MvdLande/Toy-Audio/V1/REV A/Toy-Audio V1.0 REV A layout.docx

Front Copper

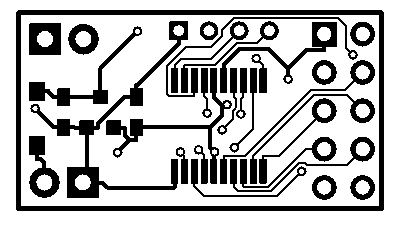
[picture p1: figure]

Front Silkscreen

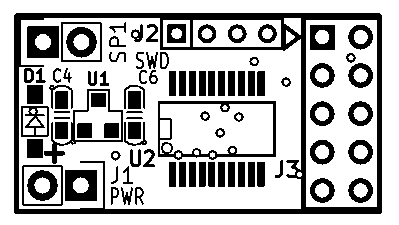
[picture p2: figure]

Back Copper

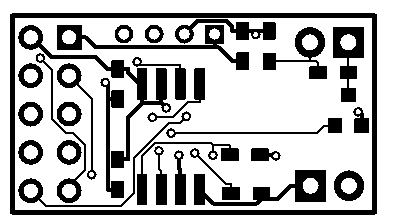
[picture p3: figure]

Back Silkscreen

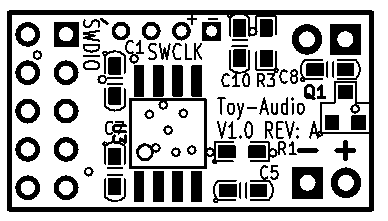
[picture p4: figure]

Toy-Audio V1.0 REV:A
