MvdLande/Toy-Audio/V1/REV A.1/doc/Toy-Audio software structure.docx

.00

I2C debug interface

Simple File System

Power Management

Serial port

WAV Player task

PWM Audio generator task

User Interface

State Machine

SPI FLASH Interface

Xmodem interface

Console Menu
