MvdLande/Toy-Audio/V1/REV A.1/doc/Toy-Audio V1.0 REV A layout.pdf

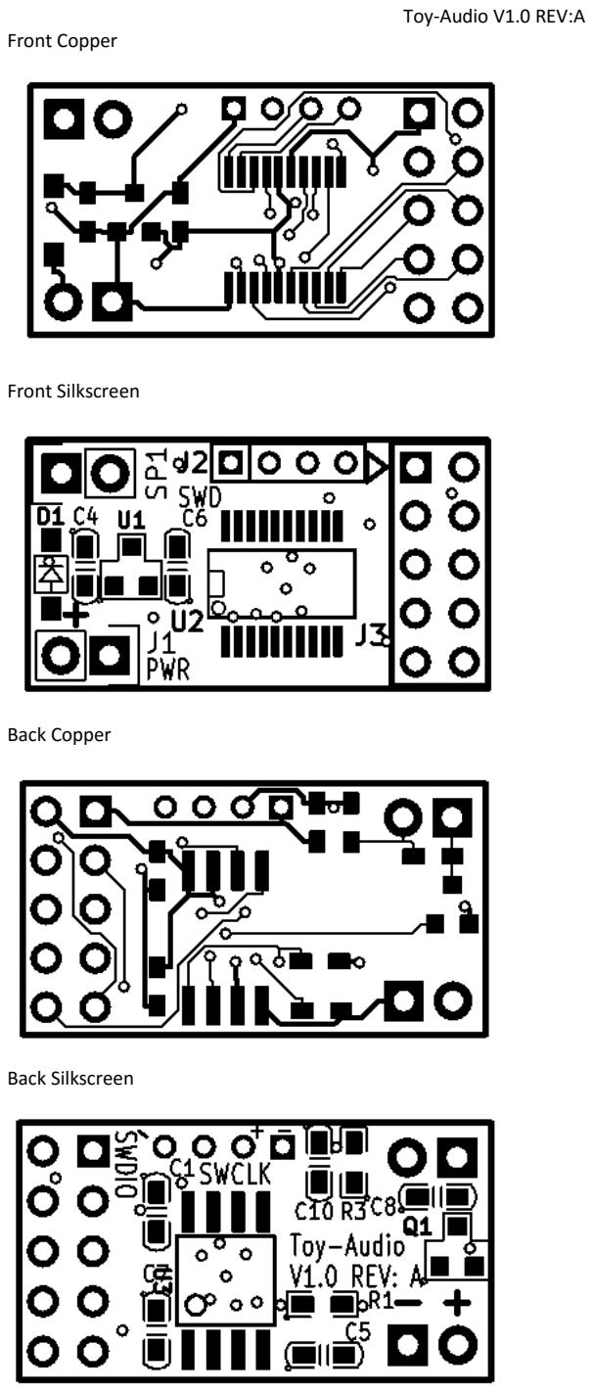
[picture p5: page 1]

Toy-Audio V1.0 REV:A
Front Copper

Front Silkscreen

Back Copper

Back Silkscreen
