MvdLande/Toy-Audio/V2/Hardware/REV A/doc/Hand Soldering guide HW V2 REV A.docx

Copper Front

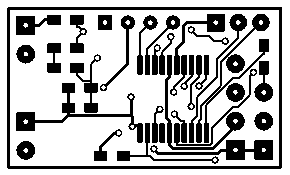
[picture p6: figure]

Components Front

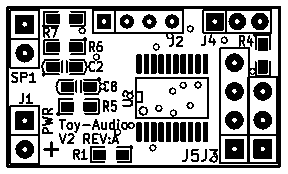
[picture p7: figure]

Copper Back

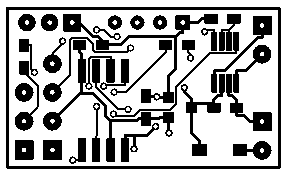
[picture p8: figure]

Components Back

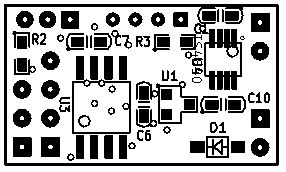
[picture p9: figure]

Toy-Audio V2 REV:A Hand soldering guide
