MvdLande/Toy-Audio/V3/Hardware/REV A/doc/Toy-Audio V3 REV A schematic.pdf

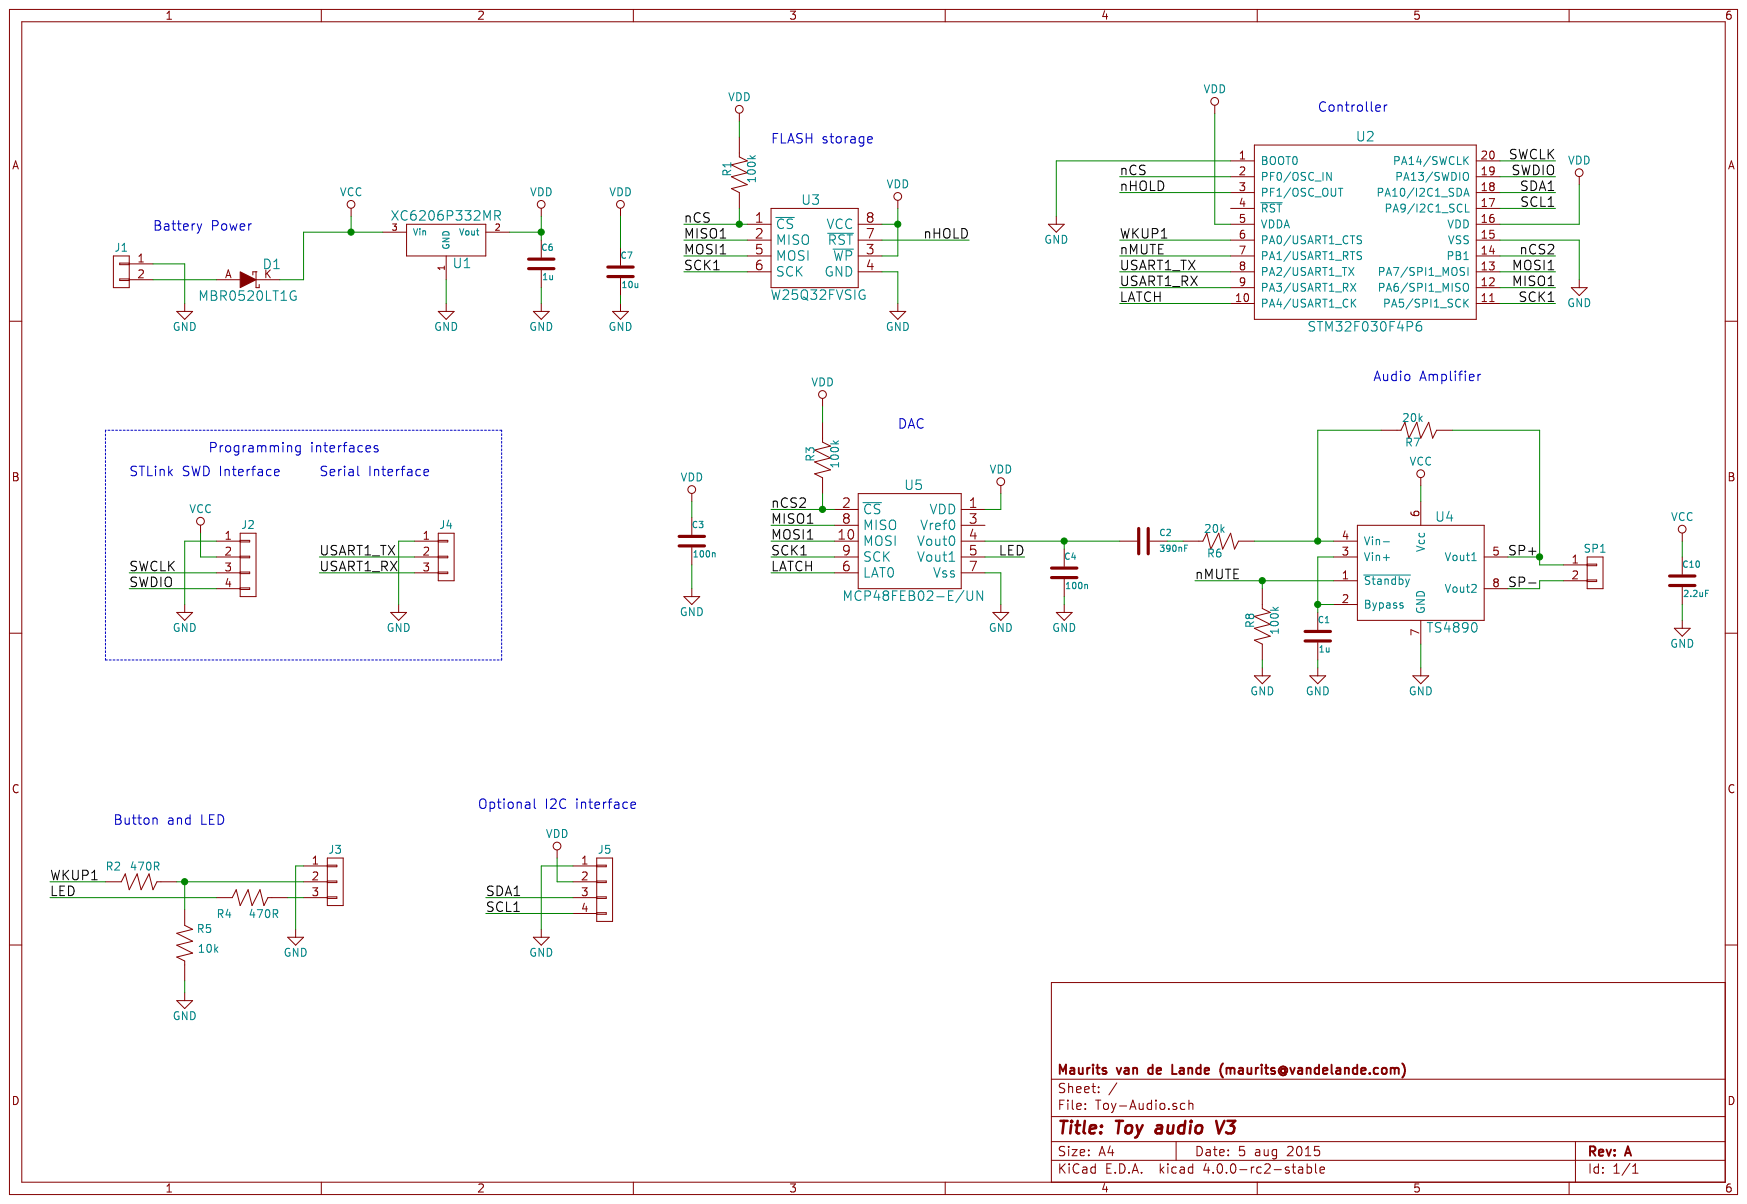
[picture p10: page 1]
