MvdLande/Toy-Audio/V1/REV A.1/doc/Toy-Audio V1.0 REV A.1 schematic.pdf

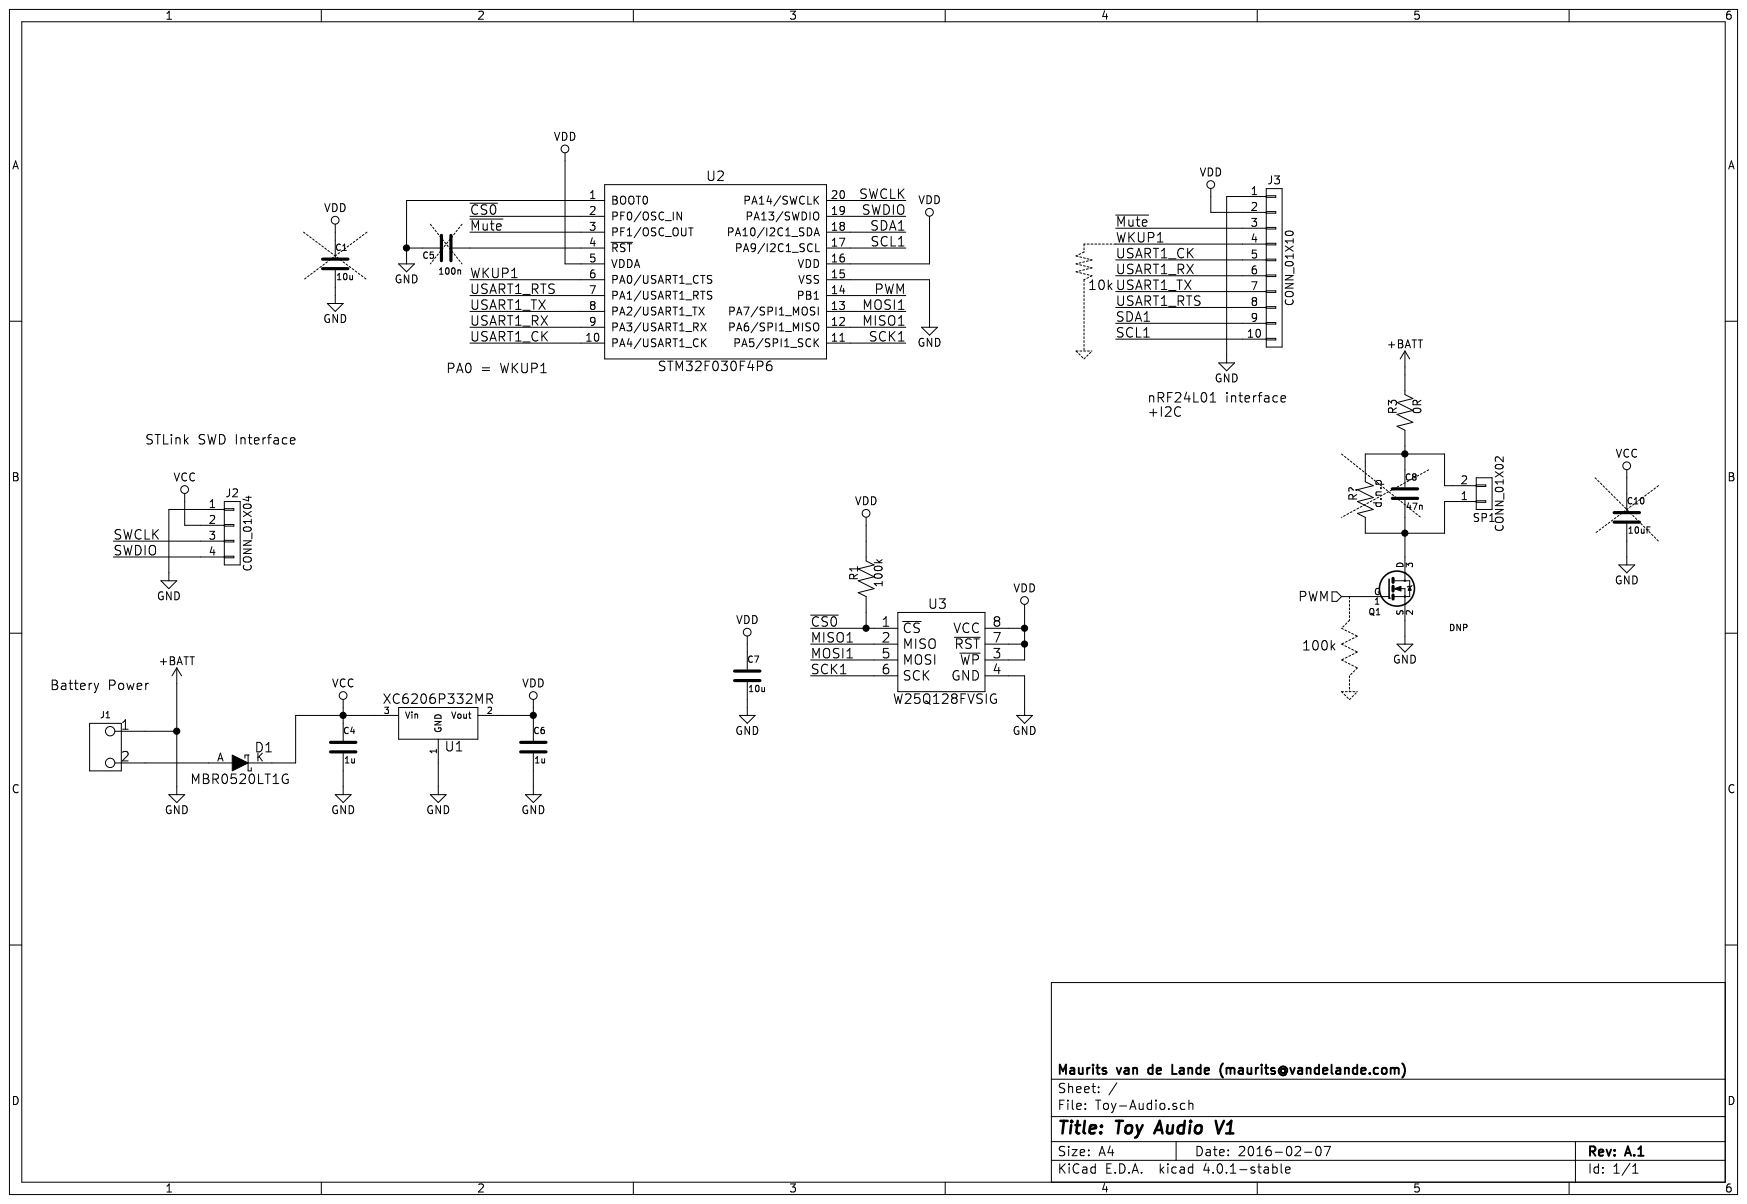
[picture p11: page 1]
