MvdLande/Toy-Audio/V1/REV A/doc/Toy-Audio V1.0 REV A schematic.pdf

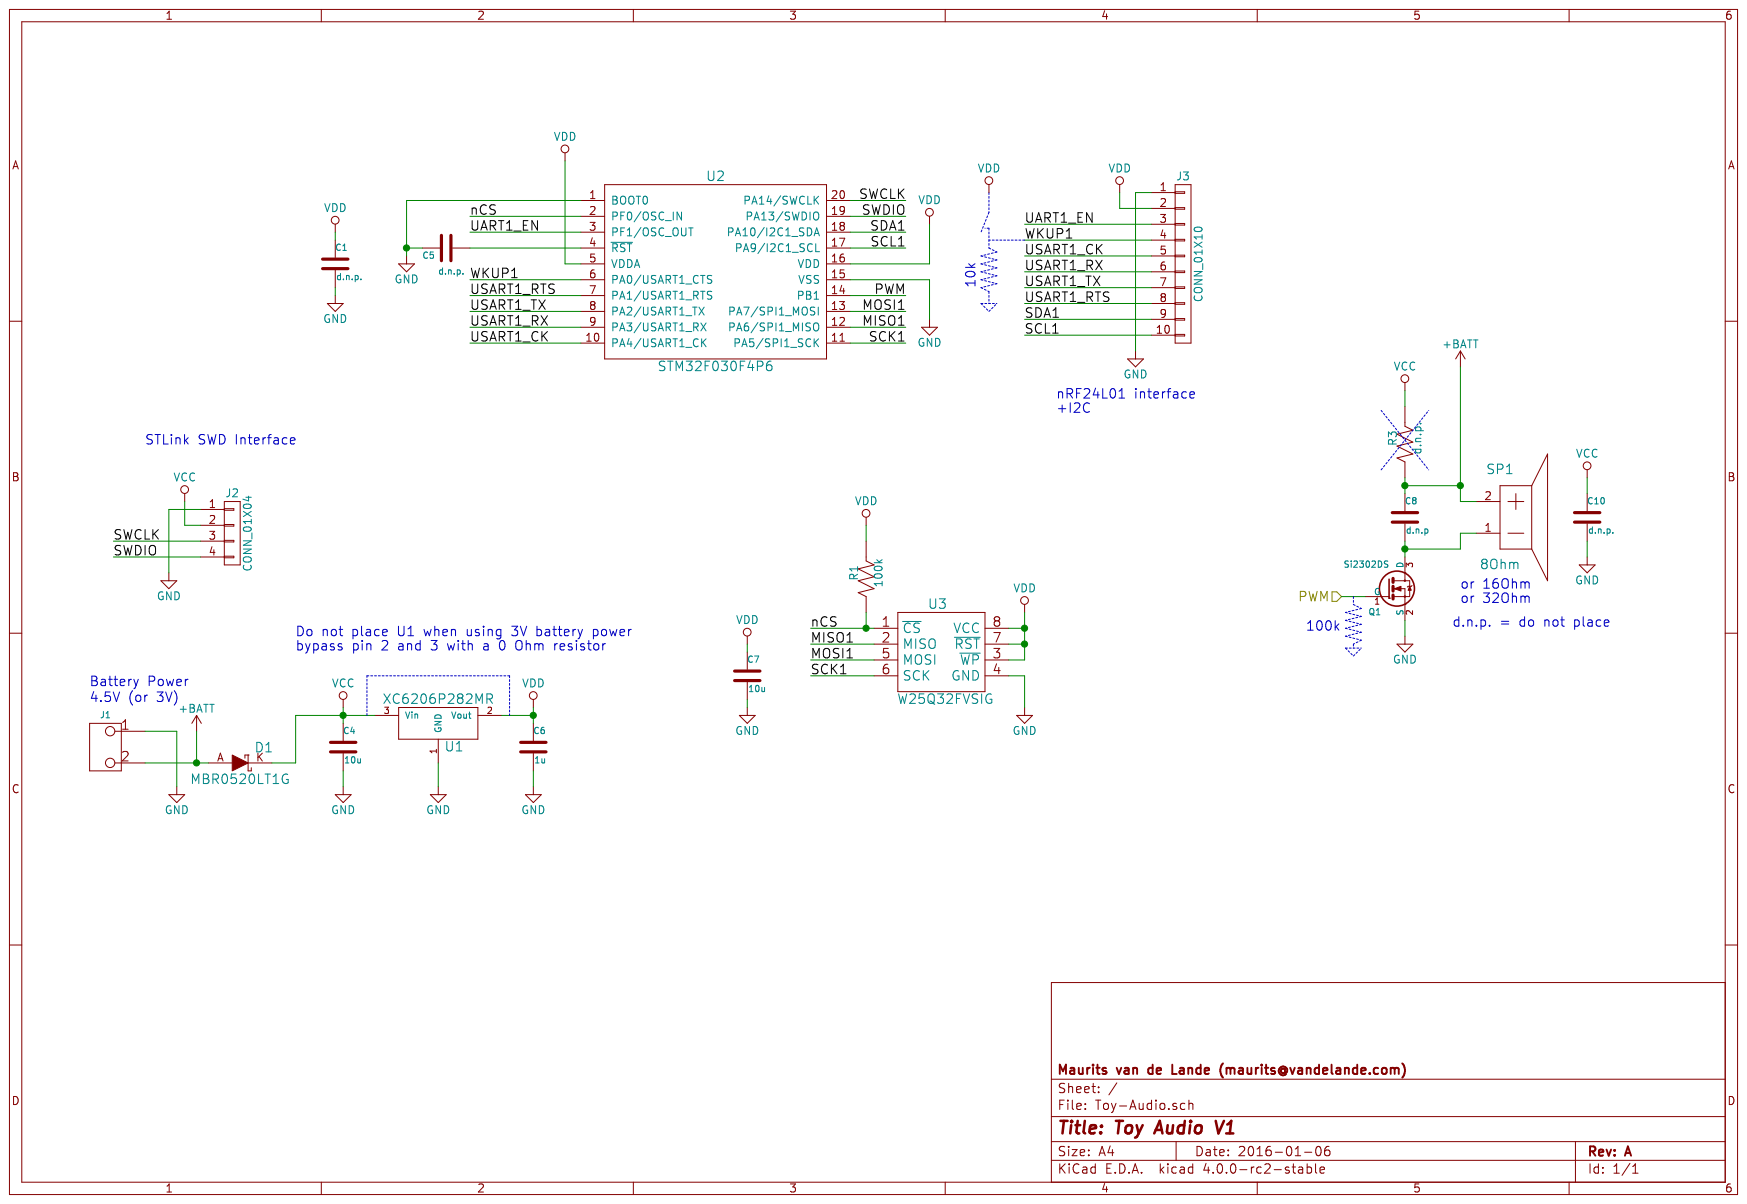
[picture p12: page 1]
