MvdLande/Toy-Audio/V1/REV B/doc/Toy-Audio V1 REV B schematic.pdf

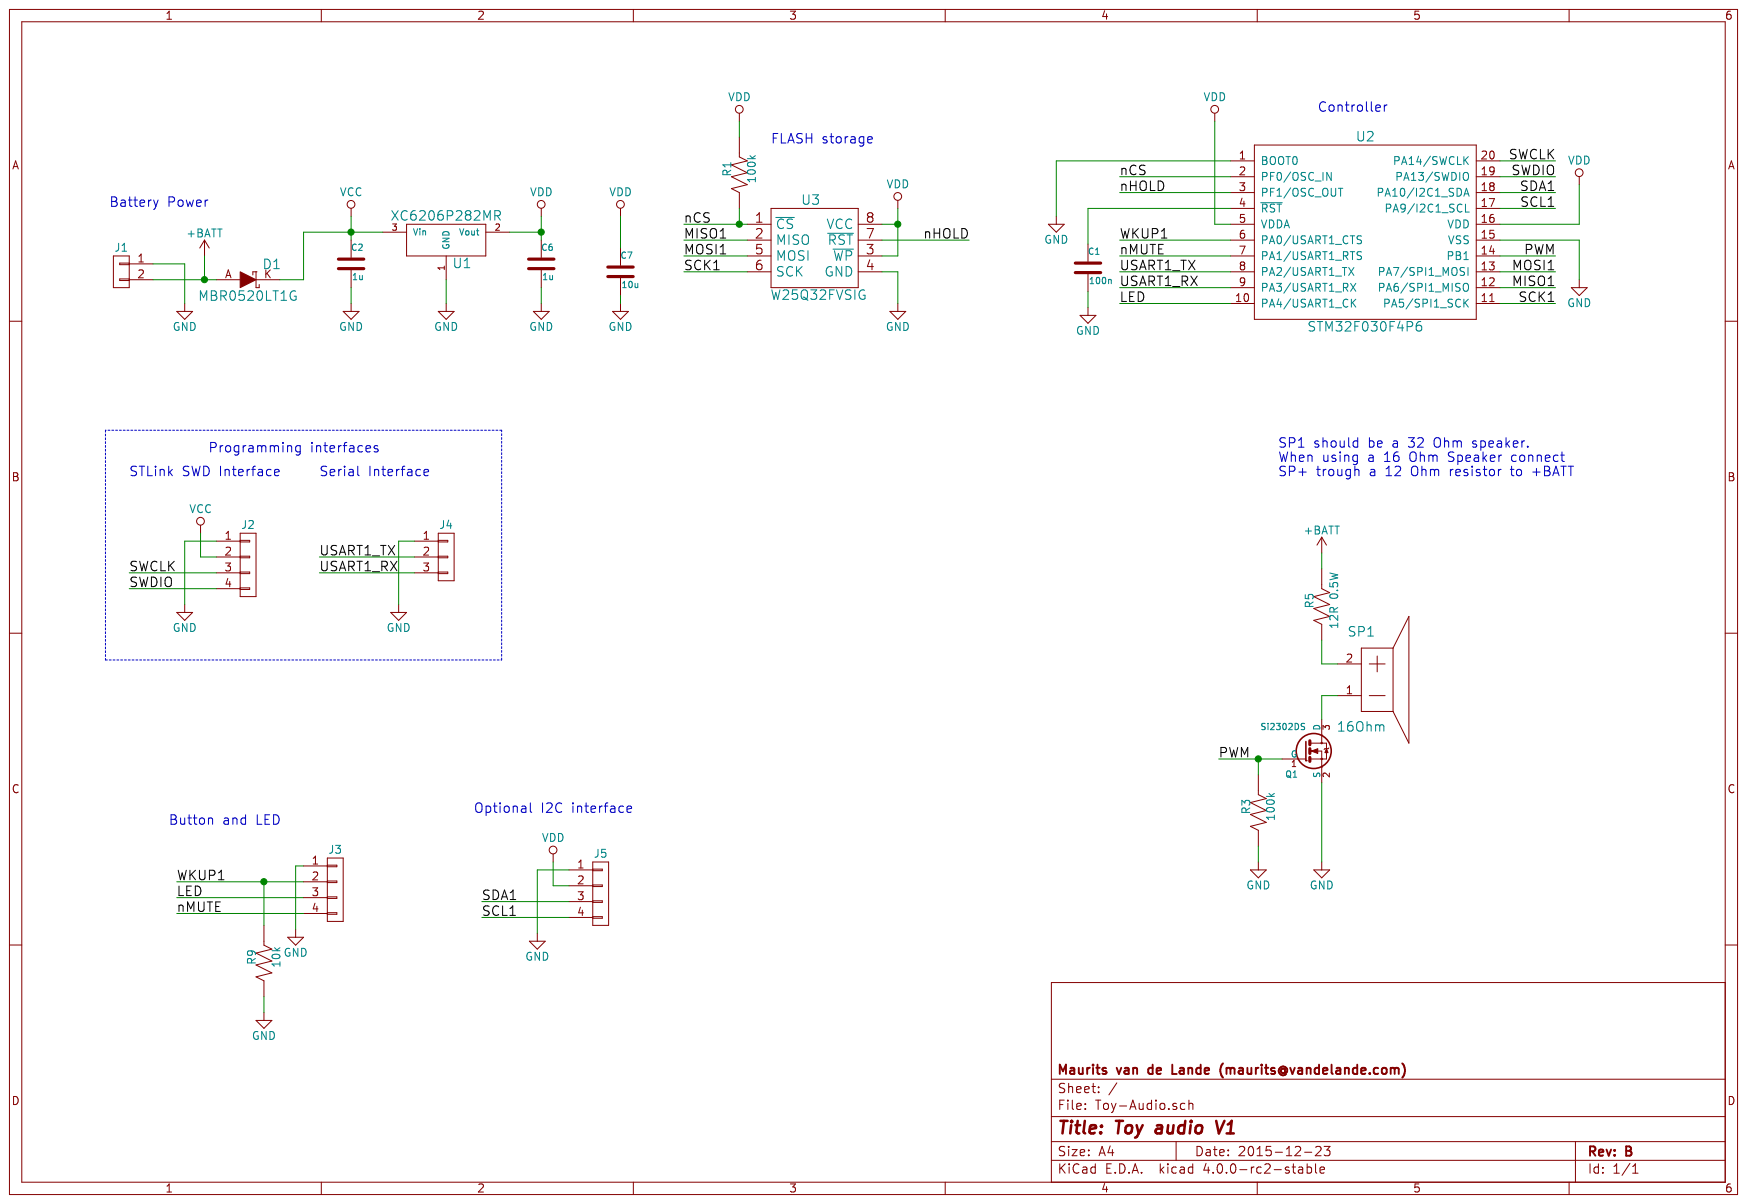
[picture p13: page 1]
