MvdLande/Toy-Audio/V1/REV A.1/doc/Toy-Audio V1.0 REV A.1 schematic test1.pdf

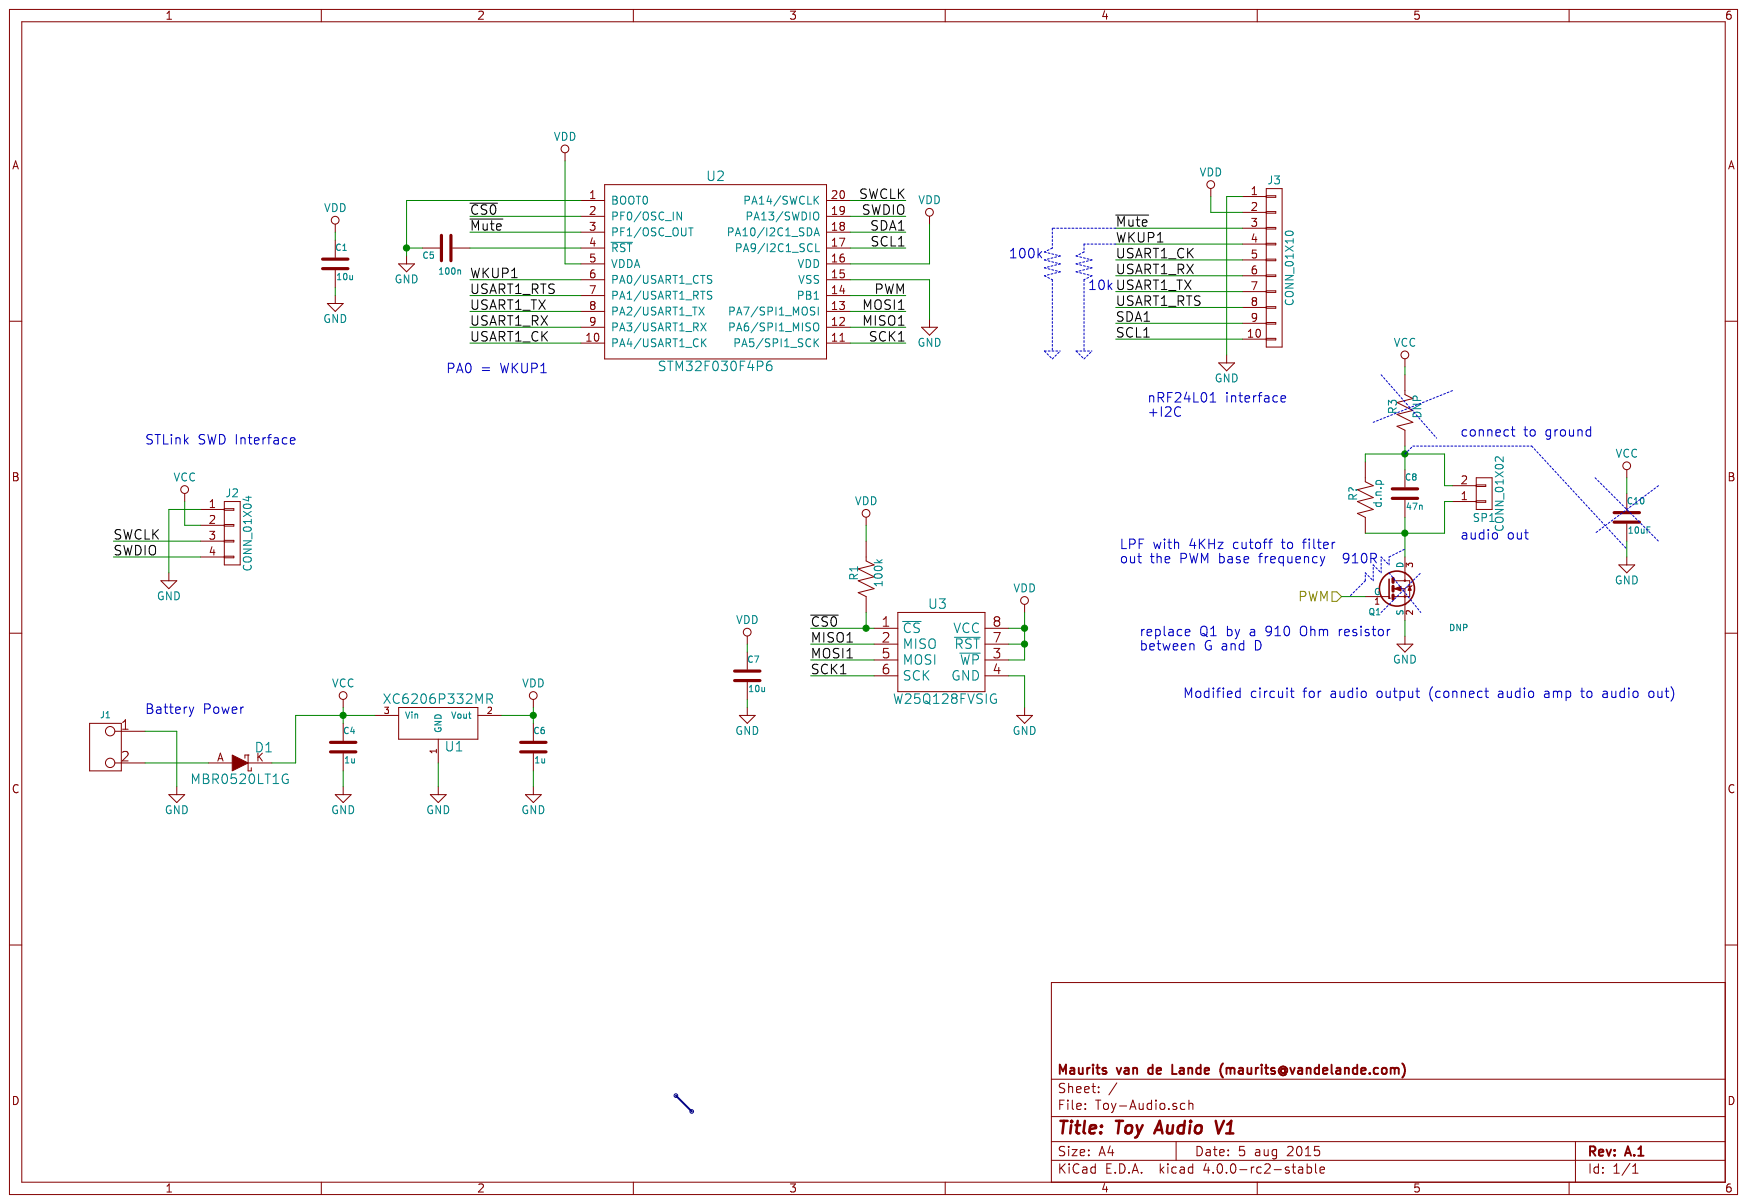
[picture p14: page 1]
