MvdLande/Toy-Audio/(list of files, drawings)

Other design files:
V1/REV A.1/Toy-Audio.dsn
V1/REV B/Toy-Audio.dsn
V2/Hardware/REV A/Toy-Audio.dsn
V3/Hardware/REV A/Toy-Audio.dsn
