MvdLande/Toy-Audio/V1/REV B/Toy-Audio.kicad_pcb

## KiCad design V1/REV B/Toy-Audio.kicad_pcb (2015-12-23, an earlier design)

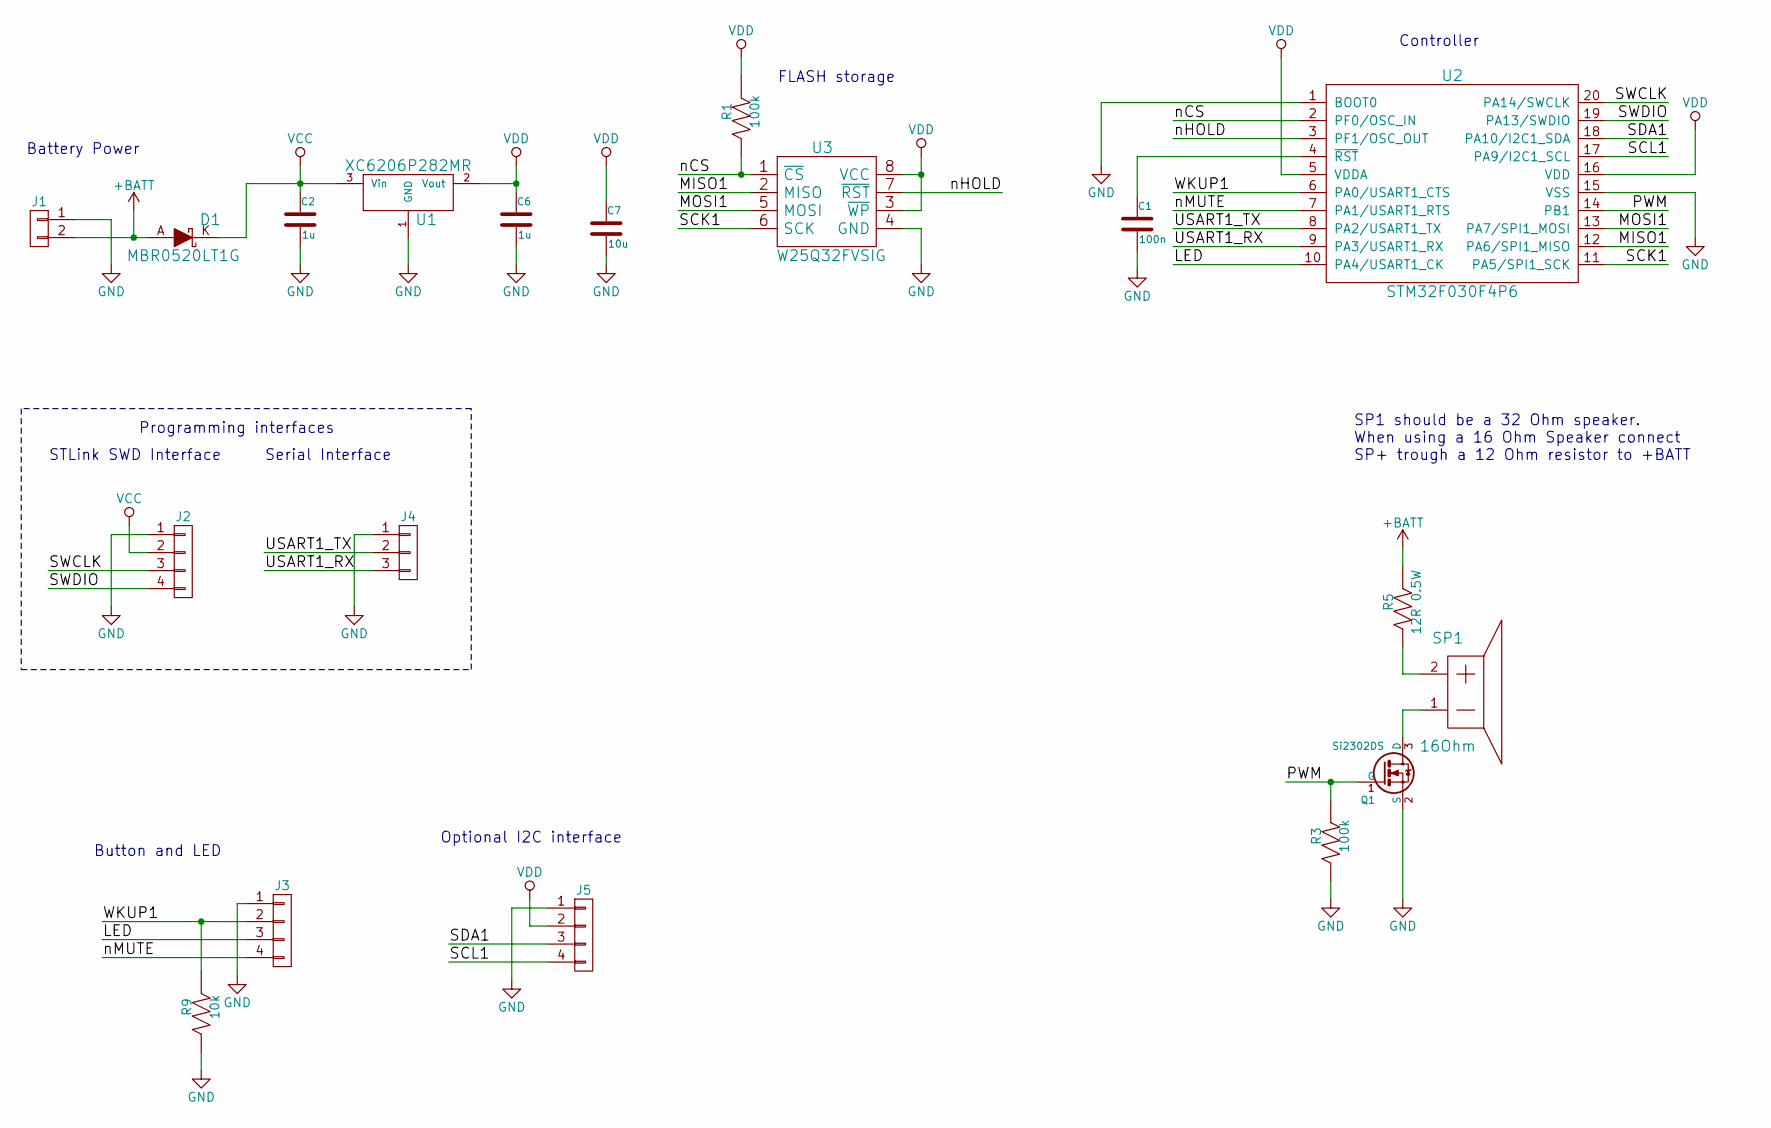
[picture p15: schematic Toy-Audio.sch, Toy audio V1]

Parts:
C1: 100n; C0603
C2, C6: 1u; C0603
C7: 10u; C0603
D1: MBR0520LT1G; SOD-123
J1: CONN_01X02; HDR_01x02_RM2.54
J2: CONN_01X04; HDR-01X4-RM2
J3, J5: CONN_01X04; HDR_01x04_RM2.54
J4: CONN_01X03; HDR-01X3-RM2
Q1: Si2302DS; SOT23
R1, R3: 100k; R0603
R5: 12R 0.5W; R0603
R9: 10k; R0603
SP1: 16Ohm; HDR_01x02_RM2.54
U1: XC6206P282MR; SOT23
U2: STM32F030F4P6; TSSOP20
U3: W25Q32FVSIG; SOIC-8-208mil

Connections:
+BATT: D1.A, J1.2, R5.2
/LED: J3.3, U2.10 (PA4/USART1_CK)
/MISO1: U2.12 (PA6/SPI1_MISO), U3.2 (MISO)
/MOSI1: U2.13 (PA7/SPI1_MOSI), U3.5 (MOSI)
/PWM: Q1.1 (G), R3.2, U2.14 (PB1)
/SCK1: U2.11 (PA5/SPI1_SCK), U3.6 (SCK)
/SCL1: J5.4, U2.17 (PA9/I2C1_SCL)
/SDA1: J5.3, U2.18 (PA10/I2C1_SDA)
/SWCLK: J2.3, U2.20 (PA14/SWCLK)
/SWDIO: J2.4, U2.19 (PA13/SWDIO)
/USART1_RX: J4.3, U2.9 (PA3/USART1_RX)
/USART1_TX: J4.2, U2.8 (PA2/USART1_TX)
/WKUP1: J3.2, R9.2, U2.6 (PA0/USART1_CTS)
/nCS: R1.1, U2.2 (PF0/OSC_IN), U3.1 (~CS)
/nHOLD: U2.3 (PF1/OSC_OUT), U3.7 (~RST)
/nMUTE: J3.4, U2.7 (PA1/USART1_RTS)
GND: C1.2, C2.2, C6.2, C7.2, J1.1, J2.1, J3.1, J4.1, J5.1, Q1.2 (S), R3.1, R9.1, U1.1 (GND), U2.1 (BOOT0), U2.15 (VSS), U3.4 (GND)
unnamed: C1.1, U2.4 (~RST)
unnamed: Q1.3 (D), SP1.1
unnamed: R5.1, SP1.2
VCC: C2.1, D1.K, J2.2, U1.3 (Vin)
VDD: C6.1, C7.1, J5.2, R1.2, U1.2 (Vout), U2.5 (VDDA), U2.16 (VDD), U3.3 (~WP), U3.8 (VCC)

Notes on the sheet:
STLink SWD Interface
Battery Power
Serial Interface
Button and LED
Optional I2C interface
Programming interfaces
FLASH storage
Controller
SP1 should be a 32 Ohm speaker. When using a 16 Ohm Speaker connect SP+ trough a 12 Ohm resistor to +BATT

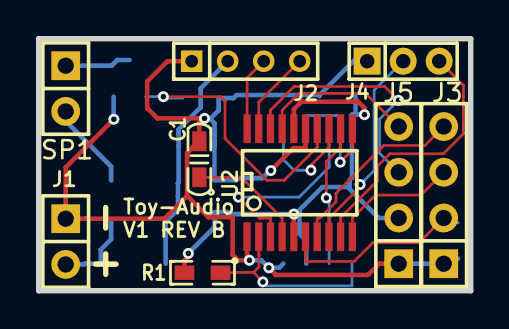
[picture p16: board V1/REV B/Toy-Audio.kicad_pcb from above]

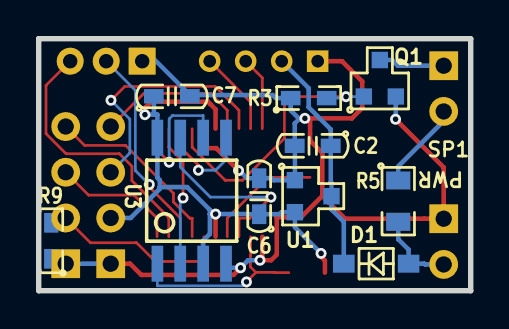
[picture p17: board V1/REV B/Toy-Audio.kicad_pcb from below]

Board: 2 copper layers, 24.0 x 14.0 mm, 19 parts (10 on the bottom side), 22 nets.
