MvdLande/Toy-Audio/V3/Hardware/REV A/Toy-Audio.kicad_pcb

## KiCad design V3/Hardware/REV A/Toy-Audio.kicad_pcb (2015-12-21)

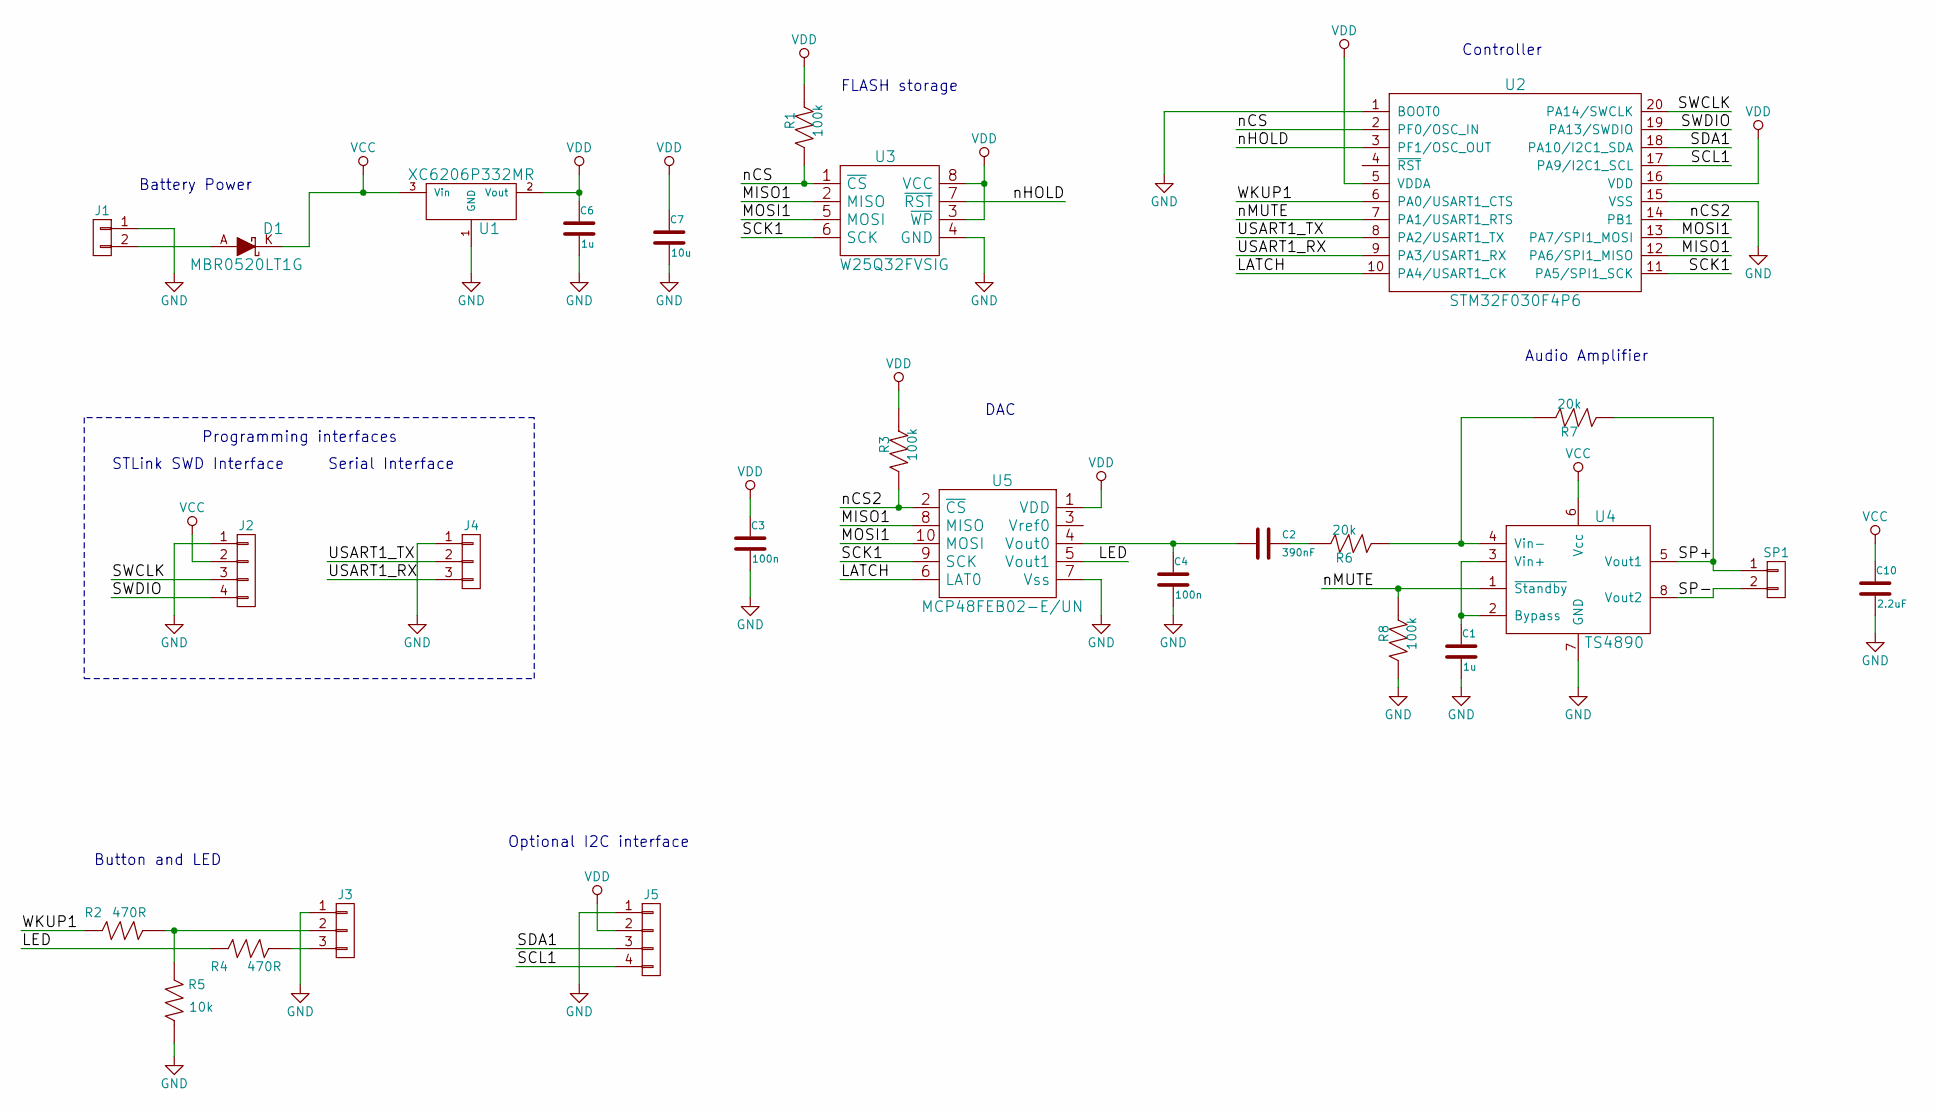
[picture p18: schematic Toy-Audio.sch, Toy audio V3]

Parts:
C1, C6: 1u; C0603
C2: 390nF; C0603
C3, C4: 100n; C0603
C7: 10u; C0603
C10: 2.2uF; C0603
D1: MBR0520LT1G; SOD-123
J1: CONN_01X02; HDR_01x02_RM2.54
J2: CONN_01X04; HDR-01X4-RM2
J3, J4: CONN_01X03; HDR_01x03_RM2.54
J5: CONN_01X04; HDR_01x04_RM2.54
R1, R3, R8: 100k; R0603
R2, R4: 470R; R0603
R5: 10k; R0603
R6, R7: 20k; R0603
SP1: CONN_01X02; HDR_01x02_RM2.54
U1: XC6206P332MR; SOT23
U2: STM32F030F4P6; TSSOP20
U3: W25Q32FVSIG; SOIC-8-208mil
U4: TS4890; MSOP8
U5: MCP48FEB02-E/UN; MSOP10

Connections:
/LATCH: U2.10 (PA4/USART1_CK), U5.6 (LAT0)
/LED: R4.1, U5.5 (Vout1)
/MISO1: U2.12 (PA6/SPI1_MISO), U3.2 (MISO), U5.8 (MISO)
/MOSI1: U2.13 (PA7/SPI1_MOSI), U3.5 (MOSI), U5.10 (MOSI)
/SCK1: U2.11 (PA5/SPI1_SCK), U3.6 (SCK), U5.9 (SCK)
/SCL1: J5.4, U2.17 (PA9/I2C1_SCL)
/SDA1: J5.3, U2.18 (PA10/I2C1_SDA)
/SP+: R7.1, SP1.1, U4.5 (Vout1)
/SP-: SP1.2, U4.8 (Vout2)
/SWCLK: J2.3, U2.20 (PA14/SWCLK)
/SWDIO: J2.4, U2.19 (PA13/SWDIO)
/USART1_RX: J4.3, U2.9 (PA3/USART1_RX)
/USART1_TX: J4.2, U2.8 (PA2/USART1_TX)
/WKUP1: R2.1, U2.6 (PA0/USART1_CTS)
/nCS: R1.1, U2.2 (PF0/OSC_IN), U3.1 (~CS)
/nCS2: R3.1, U2.14 (PB1), U5.2 (~CS)
/nHOLD: U2.3 (PF1/OSC_OUT), U3.7 (~RST)
/nMUTE: R8.2, U2.7 (PA1/USART1_RTS), U4.1 (~Standby)
GND: C1.2, C3.2, C4.2, C6.2, C7.2, C10.2, J1.1, J2.1, J3.1, J4.1, J5.1, R5.2, R8.1, U1.1 (GND), U2.1 (BOOT0), U2.15 (VSS), U3.4 (GND), U4.7 (GND), U5.7 (Vss)
unnamed: C1.1, U4.2 (Bypass), U4.3 (Vin+)
unnamed: C2.1, R6.2
unnamed: C2.2, C4.1, U5.4 (Vout0)
unnamed: D1.A, J1.2
unnamed: J3.2, R2.2, R5.1
unnamed: J3.3, R4.2
unnamed: R6.1, R7.2, U4.4 (Vin-)
VCC: C10.1, D1.K, J2.2, U1.3 (Vin), U4.6 (Vcc)
VDD: C3.1, C6.1, C7.1, J5.2, R1.2, R3.2, U1.2 (Vout), U2.5 (VDDA), U2.16 (VDD), U3.3 (~WP), U3.8 (VCC), U5.1 (VDD)

Notes on the sheet:
STLink SWD Interface
Battery Power
Serial Interface
Button and LED
Optional I2C interface
Programming interfaces
FLASH storage
Audio Amplifier
Controller
DAC

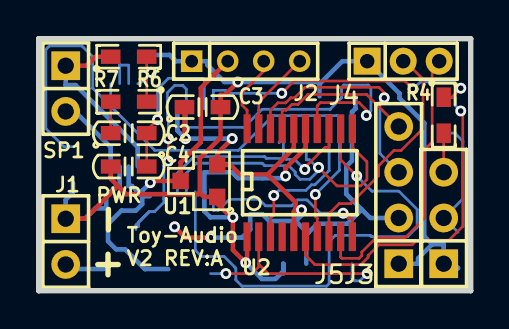
[picture p19: board V3/Hardware/REV A/Toy-Audio.kicad_pcb from above]

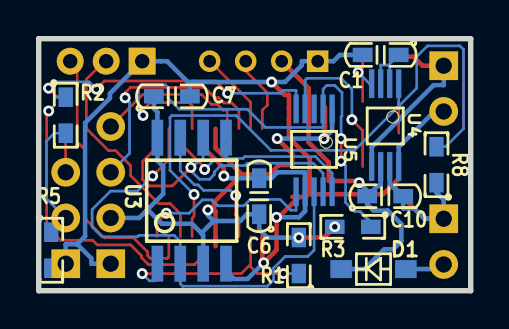
[picture p20: board V3/Hardware/REV A/Toy-Audio.kicad_pcb from below]

Board: 2 copper layers, 24.0 x 14.0 mm, 27 parts (13 on the bottom side), 28 nets.
