MvdLande/Toy-Audio/V1/REV A.1/Toy-Audio.kicad_pcb

## KiCad design V1/REV A.1/Toy-Audio.kicad_pcb (2015-12-15, an earlier design)

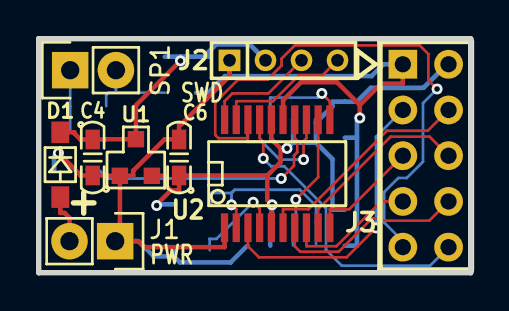
[picture p21: board V1/REV A.1/Toy-Audio.kicad_pcb from above]

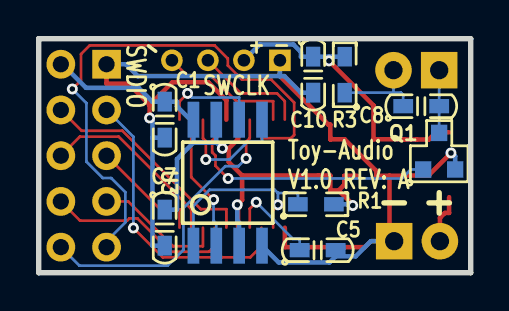
[picture p22: board V1/REV A.1/Toy-Audio.kicad_pcb from below]

Board: 2 copper layers, 24.0 x 13.0 mm, 18 parts (9 on the bottom side), 22 nets.

Parts:
C1, C4, C7: 10u; C0603
C5: 100n; C0603
C6: 1u; C0603
C8: 22nF; C0603
C10: 10uF; C0603
D1: MBR0520LT1G; SOD-123
J1: CONN_2; Pin_Header_Straight_1x02
J2: CONN_01X04; HDR-01X4-RM2
J3: CONN_01X10; HDR_5x2
Q1: Si2302DS; SOT23
R1: 100k; R0603
R3: 1R; R0603
SP1: 8Ohm; Pin_Header_Straight_1x02
U1: XC6206P332MR; SOT23
U2: STM32F030Fx; TSSOP20
U3: W25Q128FVSIG; SOIC-8-208mil

Connections:
/MISO1: U2.12, U3.2
/MOSI1: U2.13, U3.5
/PWM: Q1.1, U2.14
/SCK1: U2.11, U3.6
/SCL1: J3.10, U2.17
/SDA1: J3.9, U2.18
/SWCLK: J2.3, U2.20
/SWDIO: J2.4, U2.19
/UART2_EN: J3.3, U2.3
/USART2_CK: J3.5, U2.10
/USART2_CTS: J3.4, U2.6
/USART2_RTS: J3.8, U2.7
/USART2_RX: J3.6, U2.9
/USART2_TX: J3.7, U2.8
/~CS-FL: R1.1, U2.2, U3.1
GND: C1.2, C4.2, C5.2, C6.2, C7.2, C10.2, J1.1, J2.1, J3.1, Q1.2, U1.1, U2.1, U2.15, U3.4
unnamed: C5.1, U2.4
unnamed: C8.1, R3.1, SP1.2
unnamed: C8.2, Q1.3, SP1.1
unnamed: D1.A, J1.2
VCC: C4.1, C10.1, D1.C, J2.2, R3.2, U1.3
VDD: C1.1, C6.1, C7.1, J3.2, R1.2, U1.2, U2.5, U2.16, U3.3, U3.7, U3.8
