MvdLande/Toy-Audio/(commit log)

2015-12-15 First commit with hardware files
    [Toy-Audio.dsn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]
2015-12-15 Changed Toy-Audio.sch HW V2 REV A low Pass filter (removed voltage divider) to increase the speaker sound volume
    [Toy-Audio.sch]
2015-12-15 Added pdf version of the schematic
2015-12-15 Now really include the schematic
2015-12-15 Added Toy-Audio V2 REV A Hand soldering guide
2015-12-16 Modified PCB layout, improved hand solderability.
    [Toy-Audio.dsn, Toy-Audio.kicad_pcb, Toy-Audio.sch]
2015-12-20 Added Standby mode to software V1. Modified hardware to support Standby (add pull up/down resistors) todo hardware V3
    [Toy-Audio.dsn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]
2015-12-20 Updated HW V3 schematic and all pdf files.
    [Toy-Audio.kicad_pcb, Toy-Audio.sch]
2015-12-20 Fixed stop button
2015-12-21 Improved Wake-up pin stability WKUP1. modiefied schematic files. Software V1 is compatible with hardware V2
    [Toy-Audio.kicad_pcb, Toy-Audio.sch]
2015-12-22 Added support for SPI FLASH power down function
    [Toy-Audio.sch]
2015-12-23 added resistor between Speaker + and Vbat to improve stability during playback. (HW V1)
    [Toy-Audio.sch]
2015-12-23 Added V1 HW REV B
    [Toy-Audio.dsn, Toy-Audio.kicad_pcb, Toy-Audio.sch]
2015-12-23 Added V1 REV B schematic as PDF
2016-01-07 Minimized HW REV A, merged programming Terminal menu into main code. the menu is entered when data is received on the serial interface.
    [Toy-Audio.sch]
2016-02-07 Modified/added documentation HW V1. changed SPI flash write function to wait for data transmision complete flag.
    [Toy-Audio.sch]
